Inkybo/inky_serv/freetserv.kicad_pcb

## KiCad design freetserv.kicad_pcb (2025-05-30)

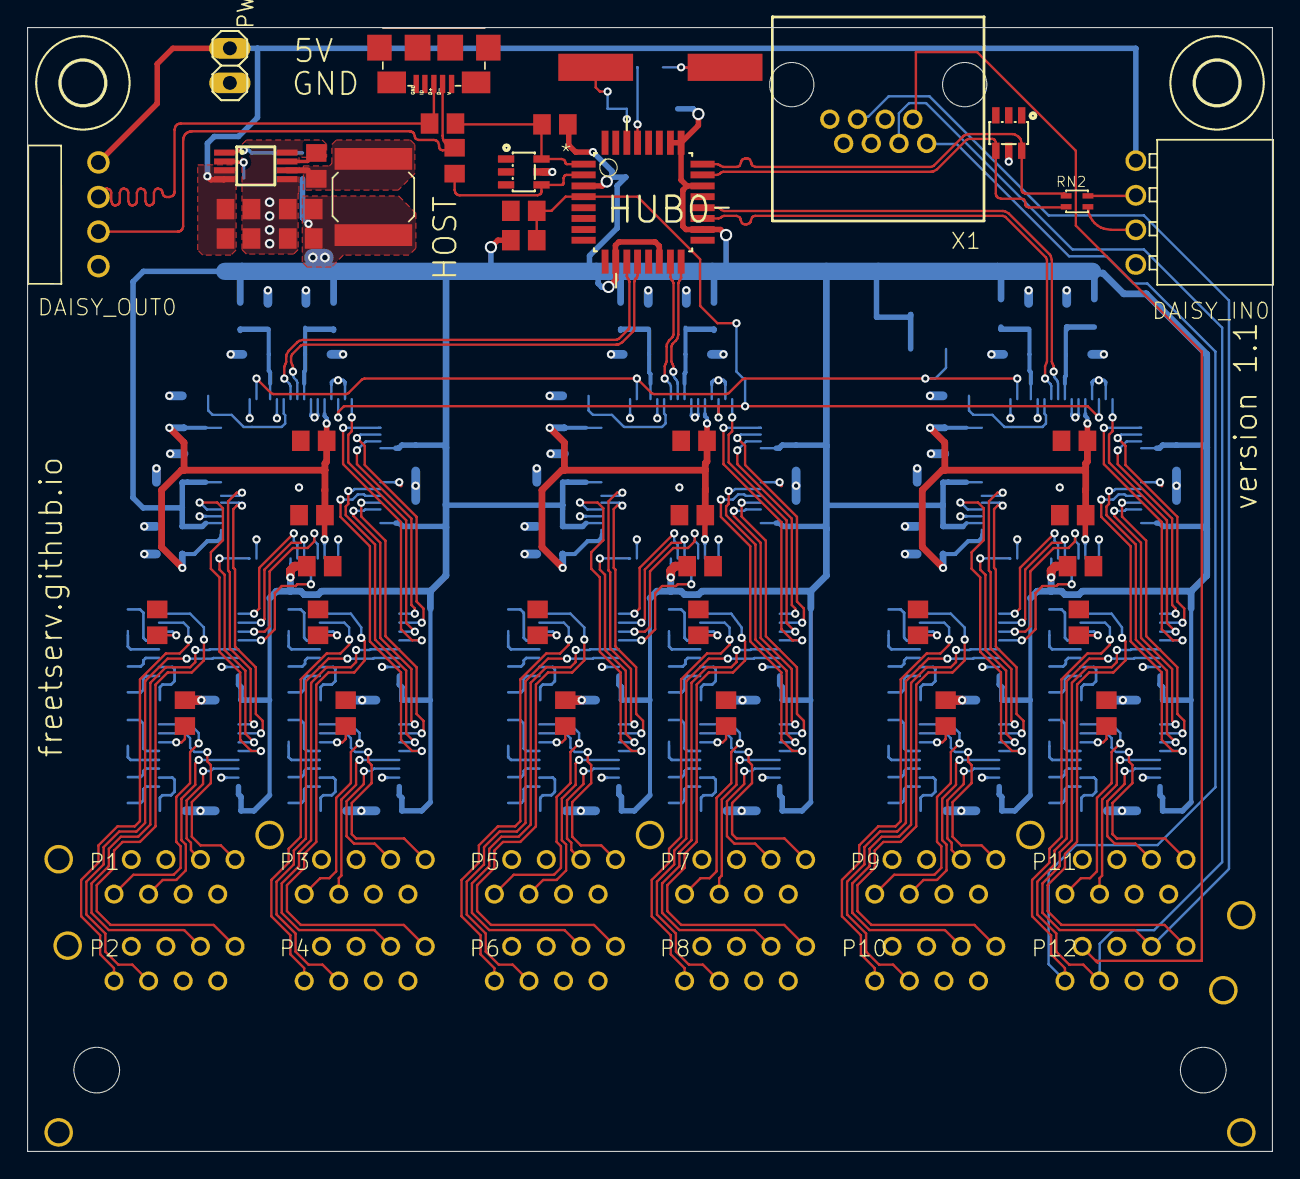
[picture p1: board freetserv.kicad_pcb from above]

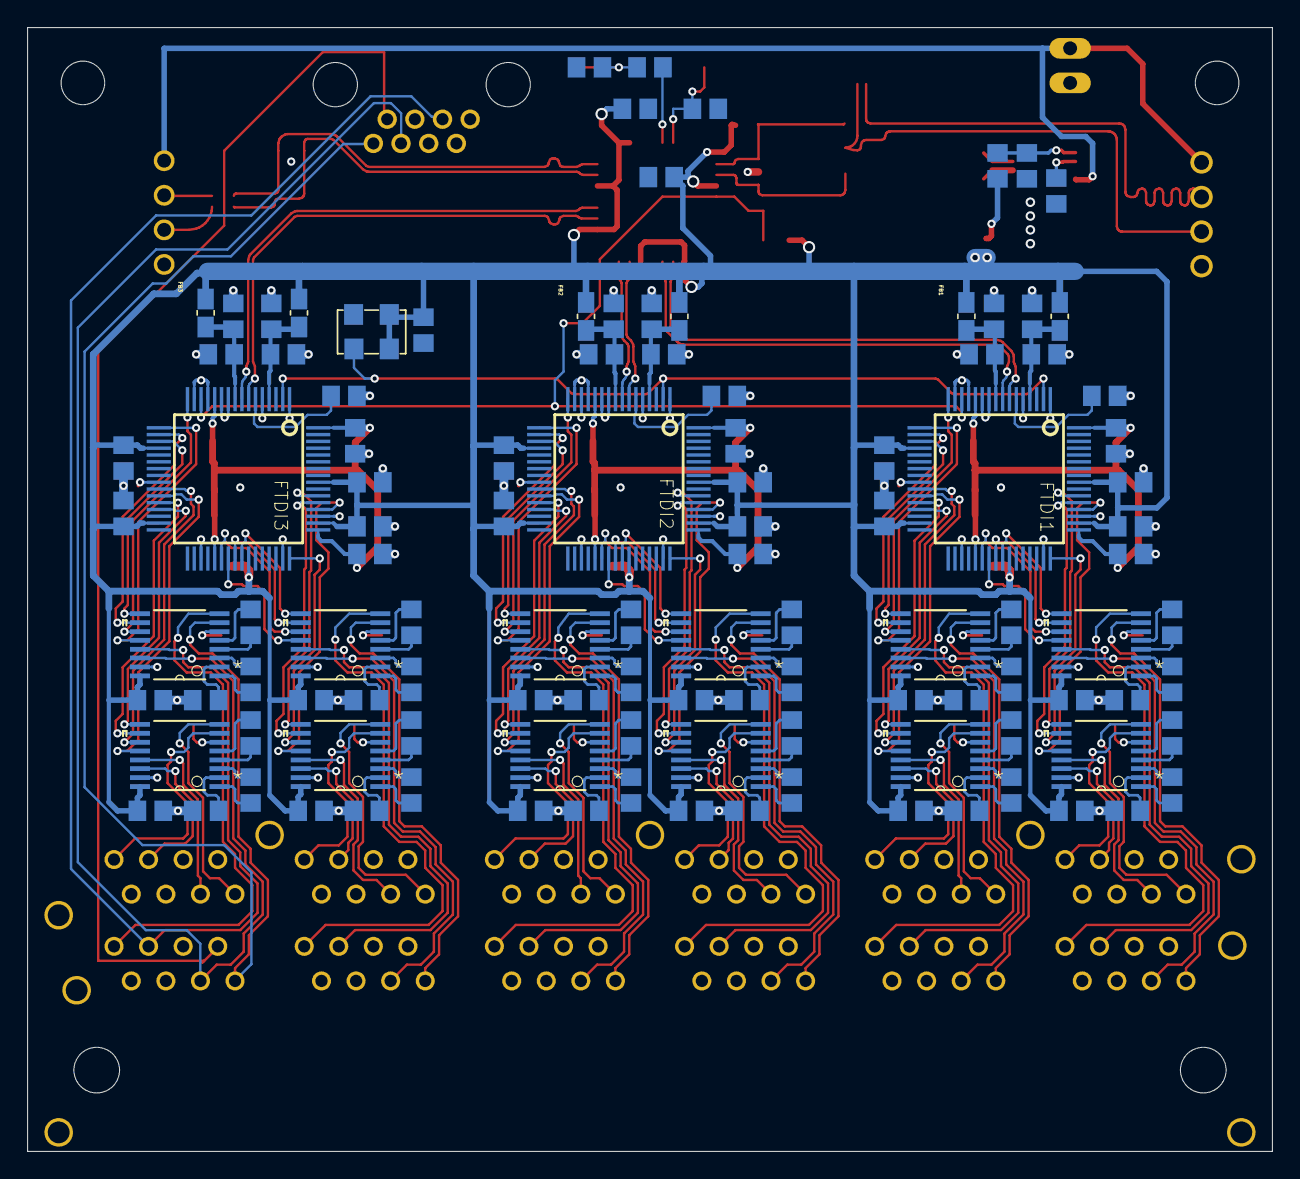
[picture p2: board freetserv.kicad_pcb from below]

Board: 16 copper layers, 91.4 x 82.6 mm, 158 parts (112 on the bottom side), 207 nets.

Parts:
C1, C4, C11, C12, C15, C16, C17, C18, C19, C22, C23, C24, C25, C26, C27, C28, C29, C30, C31, C32, C33, C34, C35, C36, C37, C38, C39, C40, C41, C42, C43, C44, C45, C46, C47, C54, C55, C56, C57, C58, C59, C60, C61, C62, C63, C64, C65, C66, C67, C68, C69, C70, C71, C72, C73, C74, C75, C76, C77, C78, C79, C80, C81, C89, C90, C91, C92, C93, C94, C95, C96, C97, C98, C99, C100, C101, C102, C103, C104, C105, C106, C107, C108, C109, C110, C111, C112, C113, C114, C115, C116, C489, C519, C859, C869: 0.1uF; C0805
C2, C3, C6, C7: 10uF; C0805
C5: 1uF; C0805
C8, C629, C829: 3.3uF; C0805
C13, C14, C53, C502, C879, C889: 4.7uF; C0805
C20, C21: 18pF; C0805
D1, D2: SN65220; SOT23-6
DAISY_IN0: 613004143121
DAISY_OUT0: 61300411021
FB1, FB2, FB2\0, FB2\1, FB2\2, FB3: 330; WE-KI_0805A
FTDI1, FTDI2, FTDI3: FT4232HL; LQFP64
H1, H2: MOUNT-HOLE3.2; 3,2
HUB0: TUSB2046BVF; QFP80P900X900X145-32N
IC1: MCP16311; MSOP8
IC5, IC6, IC7, IC8, IC10, IC11, IC12, IC13, IC15, IC16, IC17, IC18: 3232; SOP65P640X120-16N
L3: 15uH; NR60XX
PWRIN0: 1X02
Q2: 6MHz; CSM-7X-DU
QG1: ASFL1-12.000; XO53
R1, R8: 27; R0805
R2, R13, R15: 12K/1%; R0805
R3, R6: 1.5K; R0805
R4: 31.6k; R0805
R5: 10k; R0805
R7: 22K; R0805
RN2: 27; EXBV4V
U$1: SS73100-046F_DWG; SS73100-046F
USB_HOST0: USB_MICROB; USB_MICROB_PACKAGE
X1: 0446200001

Connections:
12MHZ: FTDI1.2, FTDI2.2, FTDI3.2, QG1.3
+1V8-1: C8.2, C38.1, C39.1, C40.1, FTDI1.12, FTDI1.37, FTDI1.49, FTDI1.64
+1V8-2: C59.1, C60.1, C61.1, C629.2, FTDI2.12, FTDI2.37, FTDI2.49, FTDI2.64
+1V8-3: C94.1, C95.1, C96.1, C829.2, FTDI3.12, FTDI3.37, FTDI3.49, FTDI3.64
+3V3: C6.1, C7.1, C19.2, C25.2, C30.2, C35.2, C36.2, C41.1, C42.1, C43.1, C44.1, C45.1, C46.2, C47.2, C58.2, C62.1, C63.1, C64.1, C65.1, C66.1, C71.2, C76.2, C81.2, C93.2, C97.1, C98.1, C99.1, C100.1, C101.1, C106.2, C111.2, C116.2, FB1.1, FB2.1, FB2\0.1, FB2\1.1, FB2\2.1, FB3.1, FTDI1.20, FTDI1.31, FTDI1.42, FTDI1.50, FTDI1.56, FTDI2.20, FTDI2.31, FTDI2.42, FTDI2.50, FTDI2.56, FTDI3.20, FTDI3.31, FTDI3.42, FTDI3.50, FTDI3.56, HUB0.3, HUB0.10, HUB0.14, HUB0.18, HUB0.22, HUB0.25, HUB0.26, IC5.16, IC6.16, IC7.16, IC8.16, IC10.16, IC11.16, IC12.16, IC13.16, IC15.16, IC16.16, IC17.16, IC18.16, L3.2, QG1.1, QG1.4, R4.1, R6.1, R7.2
+5V: C2.1, C3.1, DAISY_IN0.1, DAISY_OUT0.1, IC1.3, IC1.4, PWRIN0.1
CTS1E: IC5.8, U$1.P4.8
CTS1E1: IC10.8, U$1.P8.8
CTS1E2: IC15.8, U$1.P12.8
CTS1I: FTDI1.19, IC5.9
CTS1I1: FTDI2.19, IC10.9
CTS1I2: FTDI3.19, IC15.9
CTS2E: IC6.8, U$1.P3.8
CTS2E1: IC11.8, U$1.P7.8
CTS2E2: IC16.8, U$1.P11.8
CTS2I: FTDI1.29, IC6.9
CTS2I1: FTDI2.29, IC11.9
CTS2I2: FTDI3.29, IC16.9
CTS3E: IC7.8, U$1.P2.8
CTS3E1: IC12.8, U$1.P6.8
CTS3E2: IC17.8, U$1.P10.8
CTS3I: FTDI1.41, IC7.9
CTS3I1: FTDI2.41, IC12.9
CTS3I2: FTDI3.41, IC17.9
CTS4E: IC8.8, U$1.P1.8
CTS4E1: IC13.8, U$1.P5.8
CTS4E2: IC18.8, U$1.P9.8
CTS4I: FTDI1.54, IC8.9
CTS4I1: FTDI2.54, IC13.9
CTS4I2: FTDI3.54, IC18.9
D0_N: D1.4, HUB0.2, R1.1
D0_P: D1.6, HUB0.1, R6.2, R8.1
D1_N: D2.4, HUB0.23, RN2.B1
D1_P: D2.6, HUB0.24, RN2.A1
D2_N: FTDI1.7, HUB0.11
D2_P: FTDI1.8, HUB0.12
D3_N: FTDI2.7, HUB0.15
D3_P: FTDI2.8, HUB0.16
D4_N: FTDI3.7, HUB0.19
D4_P: FTDI3.8, HUB0.20
DX0_N: DAISY_OUT0.3, R1.2, USB_HOST0.D-
DX0_P: DAISY_OUT0.2, R8.2, USB_HOST0.D+
ETXN: U$1.P12.2, X1.2
GND: C2.2, C3.2, C5.2, C6.2, C7.2, C8.1, C11.2, C12.2, C13.2, C14.2, C17.1, C18.1, C19.1, C20.1, C21.1, C23.1, C24.1, C25.1, C28.1, C29.1, C30.1, C33.1, C34.1, C35.1, C36.1, C37.1, C38.2, C39.2, C40.2, C41.2, C42.2, C43.2, C44.2, C45.2, C46.1, C47.1, C53.2, C56.1, C57.1, C58.1, C59.2, C60.2, C61.2, C62.2, C63.2, C64.2, C65.2, C66.2, C69.1, C70.1, C71.1, C74.1, C75.1, C76.1, C79.1, C80.1, C81.1, C91.1, C92.1, C93.1, C94.2, C95.2, C96.2, C97.2, C98.2, C99.2, C100.2, C101.2, C104.1, C105.1, C106.1, C109.1, C110.1, C111.1, C114.1, C115.1, C116.1, C489.2, C502.2, C519.2, C629.1, C829.1, C859.2, C869.2, C879.2, C889.2, D1.2, D1.5, D2.2, D2.5, DAISY_IN0.4, DAISY_OUT0.4, FTDI1.1, FTDI1.5, FTDI1.10, FTDI1.11, FTDI1.13, FTDI1.15, FTDI1.25, FTDI1.35, FTDI1.47, FTDI1.51, FTDI2.1, FTDI2.5, FTDI2.10, FTDI2.11, FTDI2.13, FTDI2.15, FTDI2.25, FTDI2.35, FTDI2.47, FTDI2.51, FTDI3.1, FTDI3.5, FTDI3.10, FTDI3.11, FTDI3.13, FTDI3.15, FTDI3.25, FTDI3.35, FTDI3.47, FTDI3.51, HUB0.7, HUB0.8, HUB0.27, HUB0.28, HUB0.31, IC1.5, IC1.8, IC5.15, IC6.15, IC7.15, IC8.15, IC10.15, IC11.15, IC12.15, IC13.15, IC15.15, IC16.15, IC17.15, IC18.15, PWRIN0.2, QG1.2, R2.1, R5.2, R13.1, R15.1, U$1.P1.4, U$1.P1.5, U$1.P2.4, U$1.P2.5, U$1.P3.4, U$1.P3.5, U$1.P4.4, U$1.P4.5, U$1.P5.4, U$1.P5.5, U$1.P6.4, U$1.P6.5, U$1.P7.4, U$1.P7.5, U$1.P8.4, U$1.P8.5, U$1.P9.4, U$1.P9.5, U$1.P10.4, U$1.P10.5, U$1.P11.4, U$1.P11.5, U$1.P12.4, U$1.P12.5, USB_HOST0.GND
unnamed: C1.2, IC6.1
unnamed: C1.1, IC6.3
unnamed: C4.1, IC1.7
unnamed: C4.2, IC1.6, L3.1
unnamed: FTDI2.6, R13.2
unnamed: IC1.1, R4.2, R5.1
unnamed: DAISY_IN0.2, RN2.A2
unnamed: DAISY_IN0.3, RN2.B2
unnamed: C5.1, IC1.2
unnamed: C22.2, IC6.4
unnamed: C22.1, IC6.5
unnamed: FTDI1.6, R2.2
unnamed: C11.1, C13.1, FB2\0.2, FTDI1.4
unnamed: C12.1, C14.1, FB1.2, FTDI1.9
unnamed: C54.2, IC10.1
unnamed: C54.1, IC10.3
unnamed: C23.2, IC6.2
unnamed: C24.2, IC6.6
unnamed: C55.2, IC10.4
unnamed: C55.1, IC10.5
unnamed: C56.2, IC10.2
unnamed: C57.2, IC10.6
unnamed: C67.2, IC11.1
unnamed: C67.1, IC11.3
unnamed: C68.2, IC11.4
unnamed: C68.1, IC11.5
unnamed: C15.2, IC5.1
unnamed: C15.1, IC5.3
unnamed: C16.2, IC5.4
unnamed: C16.1, IC5.5
unnamed: C69.2, IC11.2
unnamed: C70.2, IC11.6
unnamed: HUB0.29, R3.1
unnamed: C72.2, IC12.1
unnamed: C17.2, IC5.2
unnamed: C18.2, IC5.6
unnamed: C72.1, IC12.3
unnamed: C73.2, IC12.4
unnamed: C73.1, IC12.5
unnamed: C20.2, HUB0.30, Q2.1
unnamed: C21.2, Q2.2, R3.2
unnamed: C26.2, IC7.1
unnamed: C26.1, IC7.3
unnamed: C27.2, IC7.4
unnamed: C27.1, IC7.5
unnamed: C74.2, IC12.2
unnamed: C75.2, IC12.6
unnamed: C28.2, IC7.2
unnamed: C29.2, IC7.6
unnamed: C77.1, IC13.3
unnamed: C78.2, IC13.4
unnamed: C78.1, IC13.5
unnamed: C79.2, IC13.2
unnamed: C80.2, IC13.6
unnamed: C31.2, IC8.1
unnamed: C31.1, IC8.3
unnamed: C32.2, IC8.4
unnamed: C32.1, IC8.5
unnamed: FTDI3.6, R15.2
unnamed: C33.2, IC8.2
unnamed: C34.2, IC8.6
unnamed: C859.1, C879.1, FB2\2.2, FTDI3.4
unnamed: C869.1, C889.1, FB3.2, FTDI3.9
unnamed: C89.2, IC15.1
unnamed: C89.1, IC15.3
unnamed: C90.2, IC15.4
unnamed: C90.1, IC15.5
unnamed: C91.2, IC15.2
unnamed: C92.2, IC15.6
unnamed: C102.2, IC16.1
unnamed: C102.1, IC16.3
unnamed: C103.2, IC16.4
unnamed: C103.1, IC16.5
unnamed: C104.2, IC16.2
unnamed: C105.2, IC16.6
unnamed: C107.2, IC17.1
unnamed: C107.1, IC17.3
unnamed: C108.2, IC17.4
unnamed: C108.1, IC17.5
unnamed: C109.2, IC17.2
unnamed: C110.2, IC17.6
unnamed: C112.2, IC18.1
unnamed: C112.1, IC18.3
unnamed: C113.2, IC18.4
unnamed: C113.1, IC18.5
unnamed: C114.2, IC18.2
unnamed: C115.2, IC18.6
unnamed: C489.1, C502.1, FB2\1.2, FTDI2.4
unnamed: C53.1, C519.1, FB2.2, FTDI2.9
unnamed: C77.2, IC13.1
RTS1E: IC5.7, U$1.P4.1
RTS1E1: IC10.7, U$1.P8.1
RTS1E2: IC15.7, U$1.P12.1, X1.1
RTS1I: FTDI1.18, IC5.10
RTS1I1: FTDI2.18, IC10.10
RTS1I2: FTDI3.18, IC15.10
RTS2E: IC6.7, U$1.P3.1
RTS2E1: IC11.7, U$1.P7.1
RTS2E2: IC16.7, U$1.P11.1
RTS2I: FTDI1.28, IC6.10
RTS2I1: FTDI2.28, IC11.10
RTS2I2: FTDI3.28, IC16.10
RTS3E: IC7.7, U$1.P2.1
RTS3E1: IC12.7, U$1.P6.1
RTS3E2: IC17.7, U$1.P10.1
RTS3I: FTDI1.40, IC7.10
RTS3I1: FTDI2.40, IC12.10
RTS3I2: FTDI3.40, IC17.10
RTS4E: IC8.7, U$1.P1.1
RTS4E1: IC13.7, U$1.P5.1
RTS4E2: IC18.7, U$1.P9.1
RTS4I: FTDI1.53, IC8.10
RTS4I1: FTDI2.53, IC13.10
RTS4I2: FTDI3.53, IC18.10
RXD1E: IC5.13, U$1.P4.6
RXD1E1: IC10.13, U$1.P8.6
RXD1E2: IC15.13, U$1.P12.6, X1.6
RXD1I: FTDI1.17, IC5.12
RXD1I1: FTDI2.17, IC10.12
RXD1I2: FTDI3.17, IC15.12
RXD2E: IC6.13, U$1.P3.6
RXD2E1: IC11.13, U$1.P7.6
RXD2E2: IC16.13, U$1.P11.6
RXD2I: FTDI1.27, IC6.12
RXD2I1: FTDI2.27, IC11.12
RXD2I2: FTDI3.27, IC16.12
RXD3E: IC7.13, U$1.P2.6
RXD3E1: IC12.13, U$1.P6.6
RXD3E2: IC17.13, U$1.P10.6
RXD3I: FTDI1.39, IC7.12
RXD3I1: FTDI2.39, IC12.12
RXD3I2: FTDI3.39, IC17.12
RXD4E: IC8.13, U$1.P1.6
RXD4E1: IC13.13, U$1.P5.6
RXD4E2: IC18.13, U$1.P9.6
RXD4I: FTDI1.52, IC8.12
RXD4I1: FTDI2.52, IC13.12
RXD4I2: FTDI3.52, IC18.12
TXD1E: IC5.14, U$1.P4.3
TXD1E1: IC10.14, U$1.P8.3
TXD1E2: IC15.14, U$1.P12.3, X1.3
TXD1I: FTDI1.16, IC5.11
TXD1I1: FTDI2.16, IC10.11
TXD1I2: FTDI3.16, IC15.11
TXD2E: IC6.14, U$1.P3.3
TXD2E1: IC11.14, U$1.P7.3
TXD2E2: IC16.14, U$1.P11.3
TXD2I: FTDI1.26, IC6.11
TXD2I1: FTDI2.26, IC11.11
TXD2I2: FTDI3.26, IC16.11
TXD3E: IC7.14, U$1.P2.3
TXD3E1: IC12.14, U$1.P6.3
TXD3E2: IC17.14, U$1.P10.3
TXD3I: FTDI1.38, IC7.11
TXD3I1: FTDI2.38, IC12.11
TXD3I2: FTDI3.38, IC17.11
TXD4E: IC8.14, U$1.P1.3
TXD4E1: IC13.14, U$1.P5.3
TXD4E2: IC18.14, U$1.P9.3
TXD4I: FTDI1.48, IC8.11
TXD4I1: FTDI2.48, IC13.11
TXD4I2: FTDI3.48, IC18.11
~RESET: C37.2, FTDI1.14, FTDI2.14, FTDI3.14, HUB0.4, R7.1
